makejimmi/FABI/Case Designs/FABI_PCB_Bottom.stl

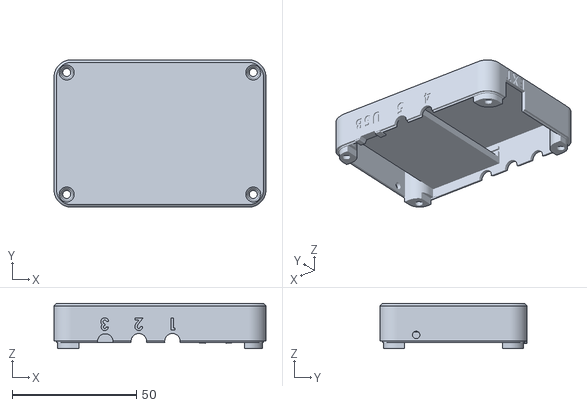
[picture p1: CAD file, 2025-01-18]
Case Designs/FABI_PCB_Bottom.stl
85.2 x 59.2 x 18.2
