makejimmi/FABI/Case Designs/FABI_PCB_Top.stl

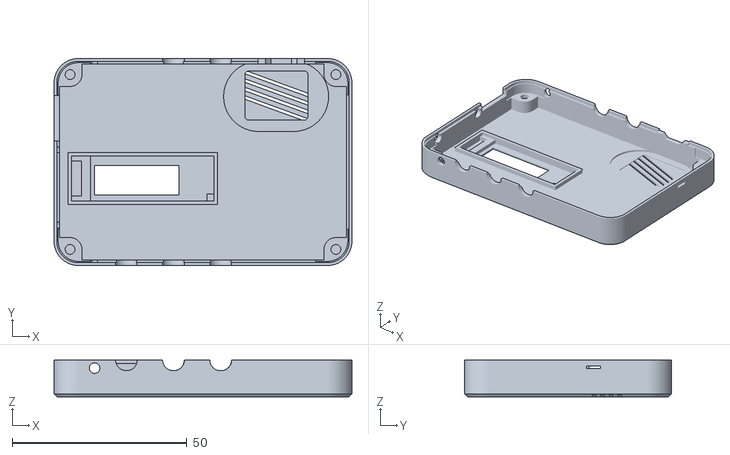
[picture p2: CAD file, 2025-01-18]
Case Designs/FABI_PCB_Top.stl
85.2 x 59.2 x 10.5
