makejimmi/FABI/hardware/FABI_schematic.kicad_pcb

## KiCad design hardware/FABI_schematic.kicad_pcb (2025-01-18)

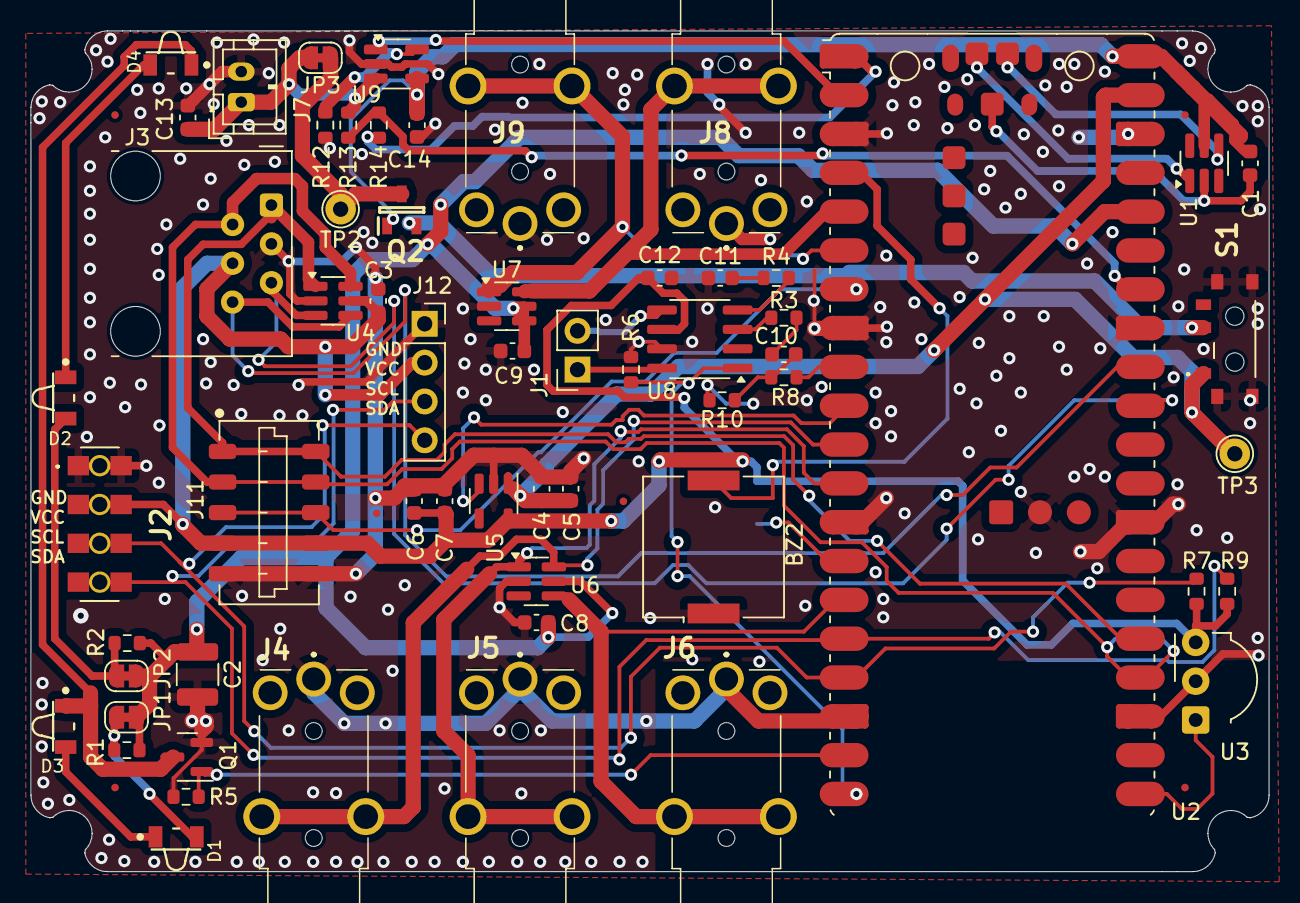
[picture p3: board FABI_schematic.kicad_pcb from above]

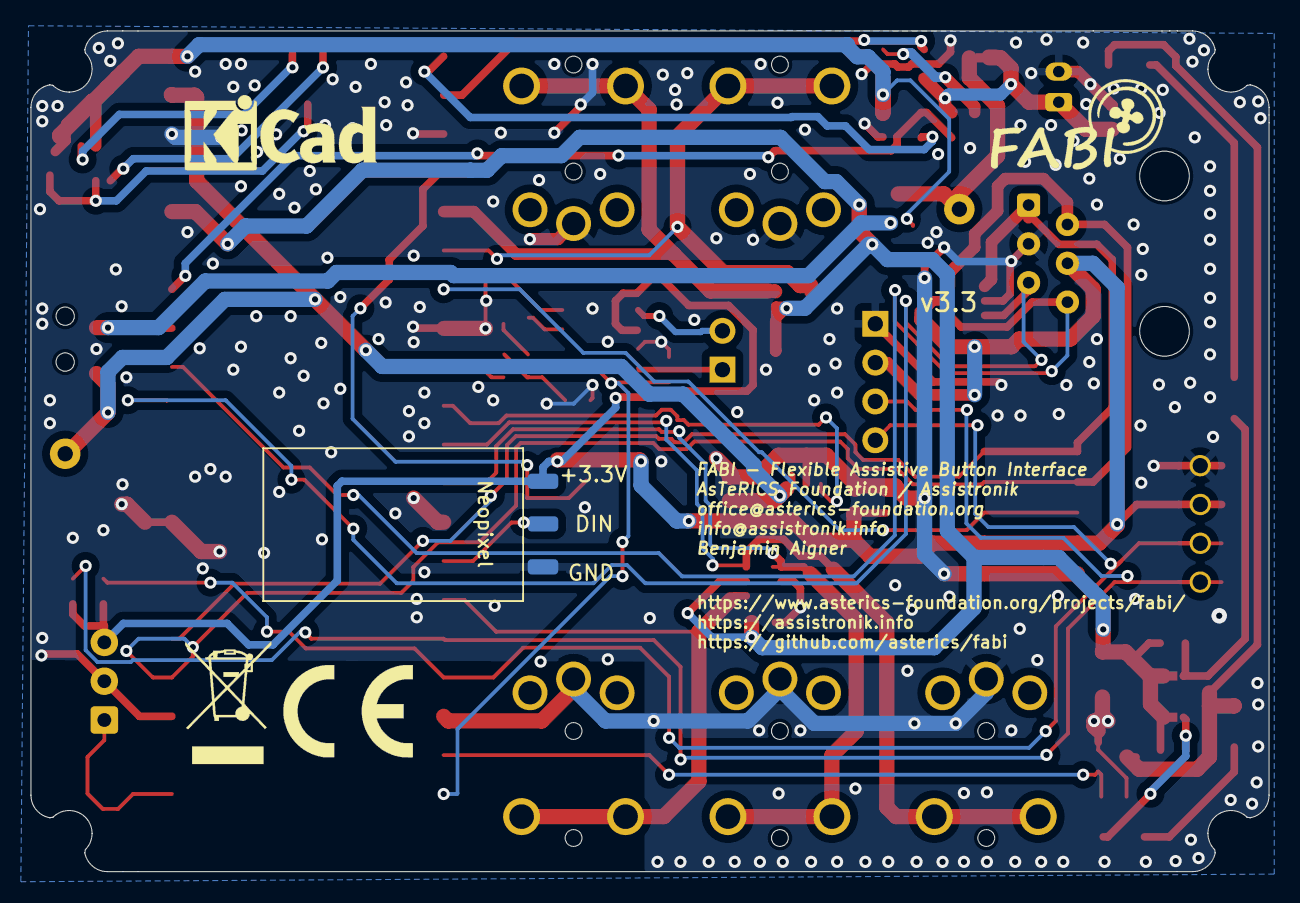
[picture p4: board FABI_schematic.kicad_pcb from below]

Board: 2 copper layers, 81.0 x 55.0 mm, 73 parts (7 on the bottom side), 46 nets.

Parts:
BZ2: PKMCS0909E4000; Buzzer_Murata_PKMCS0909E
C1, C3, C5, C6, C8, C9: 100n; C_0603_1608Metric
C2: 100uF/6.3V; C_1210_3225Metric
C4, C7: 1uF / >6.3V / X7R; C_0603_1608Metric
C10, C11: 1u; C_0603_1608Metric
C12: 10u; C_0603_1608Metric
C13, C14: 4.7u; C_0603_1608Metric
D1, D2, D3, D4: SFH4045; SFH4045N
FID1, FID2, FID3, FID4, FID5, FID6: Fiducial; Fiducial_0.5mm_Mask1mm
J1: Conn_01x02_Pin; PinSocket_1x02_P2.54mm_Vertical
J2: display_connector_91601-304LF; 91601304LF
J3: 54601-906WPLF; RJ12_Amphenol_54601-x06_Horizontal
J4, J5, J6, J8, J9: 54-00174 / FC68125; FC68125
J7: JST PH2P ST; JST_PH_B2B-PH-K_1x02_P2.00mm_Vertical
J11: 009159005551906
J11_GND1, J11_VDD1, J11_data1: Conn_01x01_Male; SolderWirePad_1x01_SMD_1x2mm_NOPASTE
J12: Conn_01x04_Socket; PinSocket_1x04_P2.54mm_Vertical
JP1, JP2, JP3: SolderJumper_2_Bridged; SolderJumper-2_P1.3mm_Bridged_RoundedPad1.0x1.5mm
LOGO1: Logo_FABI; FABI_Logo_s
LOGO2: Logo_KiCAD; KiCad-Logo_5mm_SilkScreen
LOGO3: Logo_CE; CE-Logo_8.5x6mm_SilkScreen
LOGO4: Logo_WEEE; WEEE-Logo_5.6x8mm_SilkScreen
Q1: BSS806; SOT-23
Q2: DMG2305UXQ-7; SOT96P240X110-3N
R1, R2: DNP; R_0603_1608Metric
R3, R4: 100; R_0603_1608Metric
R5, R6, R7, R9: 4k7; R_0603_1608Metric
R8, R10: 10k; R_0603_1608Metric
R12: 3k3; R_0603_1608Metric
R13, R14: 100k; R_0603_1608Metric
S1: 450404015514
TP2, TP3: TestPoint_Probe; TestPoint_THTPad_D2.0mm_Drill1.0mm
U1: D5V0F4U6SO; SC-74-6_1.55x2.9mm_P0.95mm
U2: Pico 2W; RaspberryPi_Pico_W_SMD
U3: TSOP4838; Vishay_MOLD-3Pin
U4, U6, U7: D1213A-04SO-7; SC-74-6_1.55x2.9mm_P0.95mm
U5: MIC5504-3.3YM5; SOT-23-5
U8: PAM8302AAS; SOIC-8_3.9x4.9mm_P1.27mm
U9: MCP73831-2; SOT-23-5_HandSoldering

Connections:
+3.3VADC: C3.1, C6.1, C7.1, C12.2, J2.3, J3.4, J11.4, J11_VDD1.1, J12.2, R7.2, R9.2, U3.3 (Vs), U4.5 (VBUS), U5.5 (VOUT), U8.6 (VDD)
/3V3_ADC_ENABLE: U2.10 (GPIO7), U5.3 (EN)
/Audio_SD: R6.2, U2.20 (GPIO15), U8.1 (~SD)
/Audio_Signal: R8.1, U2.9 (GPIO6)
/BUTTON1: J4.3T, U2.11 (GPIO8), U6.6 (I/O4)
/BUTTON2: J5.3T, U2.12 (GPIO9), U6.1 (I/O1)
/BUTTON3: J6.3T, U2.15 (GPIO11), U6.4 (I/O3)
/BUTTON4: J8.3T, U2.5 (GPIO3), U7.6 (I/O4)
/BUTTON5: J9.3T, U2.6 (GPIO4), U7.1 (I/O1)
/BUZZER: BZ2.2 (+), U2.4 (GPIO2)
/CHARGE_STAT: U2.2 (GPIO1), U9.1 (STAT)
/EXT1: J3.5, U2.31 (GPIO26_ADC0), U4.3 (I/O2)
/EXT2: J3.6, U2.32 (GPIO27_ADC1), U4.4 (I/O3)
/IR_LED: Q1.1 (G), R5.2, U2.19 (GPIO14)
/IR_TSOP: U2.21 (GPIO16), U3.1 (OUT)
/MPRLS_DRDY_RES: J11.3, U2.7 (GPIO5)
/NEOPIXEL: J11_data1.1, U2.14 (GPIO10)
/SCL: J3.1, J11.1, U2.25 (GPIO19), U4.1 (I/O1)
/SCL_INT: J2.5, J12.4, R7.1, U2.17 (GPIO13)
/SDA: J3.2, J11.2, U2.24 (GPIO18), U4.6 (I/O4)
/SDA_INT: J2.7, J12.3, R9.1, U2.16 (GPIO12)
/V_BATT_MEASURE: R13.2, R14.1, U2.34 (GPIO28_ADC2)
/V_BATT_VD_SWITCH: R14.2, U2.1 (GPIO0)
GND: BZ2.1 (-), C2.2, C3.2, C4.2, C5.2, C6.2, C7.2, C8.2, C9.2, C11.1, C12.1, C13.2, C14.2, J2.1, J3.3, J4.1S, J5.1S, J6.1S, J7.2, J8.1S, J9.1S, J11.5, J11_GND1.1, J12.1, Q1.2 (S), R5.1, R6.1, R10.2, R12.2, S1.MP1, S1.MP2, S1.MP3, S1.MP4, U2.3 (GND), U2.8 (GND), U2.13 (GND), U2.18 (GND), U2.23 (GND), U2.28 (GND), U2.33 (AGND), U2.38 (GND), U2.D2 (GND), U3.2 (GND), U4.2 (GND), U5.2 (GND), U6.2 (GND), U7.2 (GND), U8.7 (GND), U9.2 (V_{SS})
unnamed: C10.1, R8.2, R10.1
unnamed: C10.2, R3.2
unnamed: C11.2, R4.2
unnamed: D1.2 (A), JP1.2 (B), R1.1
unnamed: D1.1 (K), D3.2 (A)
unnamed: D2.2 (A), JP2.2 (B), R2.1
unnamed: D2.1 (K), D4.2 (A)
unnamed: D3.1 (K), D4.1 (K), Q1.3 (D)
unnamed: J1.1, U8.8 (OUT-)
unnamed: J1.2, U8.5 (OUT+)
unnamed: JP3.1 (A), Q2.3 (D), TP2.1
unnamed: C1.2, U1.2 (GND), U2.TP1 (USB_GND)
unnamed: U1.1 (I/O1), U2.TP3 (USB_DP)
unnamed: U1.4 (I/O3), U2.TP2 (USB_DM)
unnamed: R3.1, U8.3 (IN+)
unnamed: R4.1, U8.4 (IN-)
unnamed: R12.1, U9.5 (PROG)
VBUS: C1.1, C14.1, Q2.1 (G), U1.5 (VBUS), U2.40 (VBUS), U9.4 (V_{DD})
VCC: C2.1, C8.1, C9.1, JP1.1 (A), JP2.1 (A), R1.2, R2.2, U2.36 (3V3), U6.5 (VBUS), U7.4 (I/O3), U7.5 (VBUS)
VSYS: C4.1, C5.1, S1.1, TP3.1, U2.39 (VSYS), U5.1 (VIN)
V_BATT: C13.1, J7.1, JP3.2 (B), R13.1, U9.3 (V_{BAT})
V_PWR_SWITCH: Q2.2 (S), S1.2
