makejimmi/FABI/FabiWare/modes.cpp

/*
     FLipWare - AsTeRICS Foundation
     For more info please visit: https://www.asterics-foundation.org

     Module: modes.cpp: implementation of stick operation and special modes

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
*/

#include "FlipWare.h"
#include "modes.h"
#include "gpio.h"
#include "tone.h"
#include "utils.h"

/**
   static variables for mode handling
 * */
uint8_t strongSipPuffState = STRONG_MODE_IDLE;
uint8_t mouseMoveCount = 0;
unsigned long currentTime;
unsigned long previousTime = 0;


/**
   forward declarations of module-internal functions
*/
void handleMovement(); 

void handleUserInteraction()
{
  static uint8_t pressureRising = 0, pressureFalling = 0;
  static int previousPressure = 512;
  static int waitStable = 0;
  static int checkPairing = 0;
  static uint8_t puffState = SIP_PUFF_STATE_IDLE, sipState = SIP_PUFF_STATE_IDLE;
  static uint8_t puffCount = 0, sipCount = 0;
  int strongDirThreshold;

  // check physical buttons
  for (int i = 0; i < NUMBER_OF_PHYSICAL_BUTTONS; i++) // update button press / release events
  handleButton(i, digitalRead(input_map[i]) == LOW ? 1 : 0);

  #ifdef FLIPMOUSE
    // check "long-press" of internal button unpairing all BT hosts
    if (digitalRead(input_map[0]) == LOW) {
      checkPairing++;
      if (checkPairing == 800) {   // approx 4 sec.
        makeTone(TONE_BT_PAIRING, 0);
        unpairAllBT();
        checkPairing = 0;
      }
    } else checkPairing = 0;
  #endif  

  // check sip/puff activities
  if (sensorData.pressure > previousPressure) pressureRising = 1; else pressureRising = 0;
  if (sensorData.pressure < previousPressure) pressureFalling = 1; else pressureFalling = 0;
  previousPressure = sensorData.pressure;

  if (slotSettings.stickMode == STICKMODE_ALTERNATIVE)
    strongDirThreshold = 0;
  else strongDirThreshold = STRONGMODE_MOUSE_JOYSTICK_THRESHOLD;

  // handle strong sip and puff actions
  switch (strongSipPuffState)  {

    case STRONG_MODE_IDLE:   // IDLE
      if (sensorData.pressure > slotSettings.sp) {
        strongSipPuffState = STRONG_MODE_ENTER_STRONGPUFF;
        makeTone(TONE_ENTER_STRONGPUFF, 0 );
      }
      if (sensorData.pressure < slotSettings.ss ) {
        strongSipPuffState = STRONG_MODE_ENTER_STRONGSIP;
        makeTone(TONE_ENTER_STRONGSIP, 0 );
      }
      break;

    case STRONG_MODE_ENTER_STRONGPUFF:     // puffed strong, wait for release
      if (sensorData.pressure < slotSettings.tp)
        waitStable++;
      else waitStable = 0;
      if (waitStable >= STRONGMODE_STABLETIME)
        strongSipPuffState = STRONG_MODE_STRONGPUFF_ACTIVE;
      break;

    case STRONG_MODE_STRONGPUFF_ACTIVE:    // strong puff mode active
      if (sensorData.y < -strongDirThreshold) {
        makeTone(TONE_EXIT_STRONGPUFF, 0 );
        handlePress(STRONGPUFF_UP_BUTTON); handleRelease(STRONGPUFF_UP_BUTTON);
        strongSipPuffState = STRONG_MODE_RETURN_TO_IDLE;
        waitStable = 0;
      }
      else if (sensorData.x < -strongDirThreshold) {
        makeTone(TONE_EXIT_STRONGPUFF, 0 );
        handlePress(STRONGPUFF_LEFT_BUTTON); handleRelease(STRONGPUFF_LEFT_BUTTON);
        strongSipPuffState = STRONG_MODE_RETURN_TO_IDLE;
        waitStable = 0;
      }
      else if (sensorData.x > strongDirThreshold) {
        makeTone(TONE_EXIT_STRONGPUFF, 0 );
        handlePress(STRONGPUFF_RIGHT_BUTTON); handleRelease(STRONGPUFF_RIGHT_BUTTON);
        strongSipPuffState = STRONG_MODE_RETURN_TO_IDLE;
        waitStable = 0;
      }
      else if (sensorData.y > strongDirThreshold) {
        makeTone(TONE_EXIT_STRONGPUFF, 0 );
        handlePress(STRONGPUFF_DOWN_BUTTON); handleRelease(STRONGPUFF_DOWN_BUTTON);
        strongSipPuffState = STRONG_MODE_RETURN_TO_IDLE;
        waitStable = 0;
      }
      else {
        waitStable++;
        if (waitStable > STRONGMODE_EXIT_TIME) { // no stick movement occurred: perform strong puff action
          waitStable = 0;
          handlePress(STRONGPUFF_BUTTON);
          handleRelease(STRONGPUFF_BUTTON);
          strongSipPuffState = STRONG_MODE_RETURN_TO_IDLE;
        }
      }
      break;

    case STRONG_MODE_ENTER_STRONGSIP:   // sipped strong, wait for release
      if (sensorData.pressure > slotSettings.ts)
        waitStable++;
      else waitStable = 0;
      if (waitStable >= STRONGMODE_STABLETIME)
        strongSipPuffState = STRONG_MODE_STRONGSIP_ACTIVE;
      break;

    case STRONG_MODE_STRONGSIP_ACTIVE:   // strong sip mode active
      if (sensorData.y < -strongDirThreshold) {
        makeTone(TONE_EXIT_STRONGSIP, 0 );
        handlePress(STRONGSIP_UP_BUTTON); handleRelease(STRONGSIP_UP_BUTTON);
        strongSipPuffState = STRONG_MODE_RETURN_TO_IDLE;
        waitStable = 0;
      }
      else if (sensorData.x < -strongDirThreshold) {
        makeTone(TONE_EXIT_STRONGSIP, 0 );
        handlePress(STRONGSIP_LEFT_BUTTON); handleRelease(STRONGSIP_LEFT_BUTTON);
        strongSipPuffState = STRONG_MODE_RETURN_TO_IDLE;
        waitStable = 0;
      }
      else if (sensorData.x > strongDirThreshold) {
        makeTone(TONE_EXIT_STRONGSIP, 0 );
        handlePress(STRONGSIP_RIGHT_BUTTON); handleRelease(STRONGSIP_RIGHT_BUTTON);
        strongSipPuffState = STRONG_MODE_RETURN_TO_IDLE;
        waitStable = 0;
      }
      else if (sensorData.y > strongDirThreshold) {
        makeTone(TONE_EXIT_STRONGSIP, 0 );
        handlePress(STRONGSIP_DOWN_BUTTON); handleRelease(STRONGSIP_DOWN_BUTTON);
        strongSipPuffState = STRONG_MODE_RETURN_TO_IDLE;
        waitStable = 0;
      }
      else {
        waitStable++;
        if (waitStable > STRONGMODE_EXIT_TIME) {  // no stick movement occurred: perform strong sip action
          waitStable = 0;
          handlePress(STRONGSIP_BUTTON);
          handleRelease(STRONGSIP_BUTTON);
          strongSipPuffState = STRONG_MODE_RETURN_TO_IDLE;
        }
      }
      break;

    case STRONG_MODE_RETURN_TO_IDLE:
      waitStable++;
      if (waitStable > STRONGMODE_IDLE_TIME)
      {
        waitStable = 0;
        strongSipPuffState = STRONG_MODE_IDLE;
        initDebouncers();
        puffState = 0; sipState = 0;
      }
      break;
    default: break;
  }


  if (strongSipPuffState == STRONG_MODE_IDLE)
  {

    //handle normal sip and puff actions
    switch (puffState)  {
      case SIP_PUFF_STATE_IDLE:
        if (sensorData.pressure > slotSettings.tp)   // handle single puff actions
        {
          makeTone(TONE_INDICATE_PUFF, 0);
          puffState = SIP_PUFF_STATE_STARTED; puffCount = 0;
        }
        break;

      case SIP_PUFF_STATE_STARTED:
        if (!pressureRising)
        {
          if (puffCount++ > SIP_PUFF_SETTLE_TIME)
          {
            puffCount = MIN_HOLD_TIME;
            handlePress(PUFF_BUTTON);
            puffState = SIP_PUFF_STATE_PRESSED;
          }
        } else if (puffCount) puffCount--;
        break;

      case SIP_PUFF_STATE_PRESSED:
        if (puffCount) puffCount--;
        if ((sensorData.pressure < slotSettings.tp) && (!puffCount)) {
          handleRelease(PUFF_BUTTON);
          puffState = 0;
        }
    }

    switch (sipState)  {
      case SIP_PUFF_STATE_IDLE:
        if (sensorData.pressure < slotSettings.ts)   // handle single sip actions
        {
          makeTone(TONE_INDICATE_SIP, 0);
          sipState = SIP_PUFF_STATE_STARTED; sipCount = 0;
        }
        break;

      case SIP_PUFF_STATE_STARTED:
        if (!pressureFalling)
        {
          if (sipCount++ > SIP_PUFF_SETTLE_TIME)
          {
            sipCount = MIN_HOLD_TIME;
            handlePress(SIP_BUTTON);
            sipState = SIP_PUFF_STATE_PRESSED;
          }
        } else if (sipCount) sipCount--;
        break;

      case SIP_PUFF_STATE_PRESSED:
        if (sipCount) sipCount--;
        if ((sensorData.pressure > slotSettings.ts) && (!sipCount)) {
          handleRelease(SIP_BUTTON);
          sipState = 0;
        }
    }

    // now handle stick movements!
    handleMovement();
  }
}

/**
   @name getAccelFactor
   @brief calculates acceleration for mouse pointer movements 
          according to sensordata and acceleration settings 
   @return float value of current acceleration factor
*/
float getAccelFactor() {
  static float accelFactor=0;
  static int xo = 0, yo = 0;
  static float accelMaxForce = 0, lastAngle = 0;

  if (sensorData.force == 0) {
    accelFactor = 0;
    accelMaxForce = 0;
    lastAngle = 0;
  }
  else {
    if (sensorData.force > accelMaxForce) accelMaxForce = sensorData.force;
    if (sensorData.force > accelMaxForce * 0.8f) {
      if (accelFactor < 1.0f)
        accelFactor += ((float)slotSettings.ac / 5000000.0f);
    }
    else if (accelMaxForce > 0) accelMaxForce *= 0.99f;

    if (sensorData.force < accelMaxForce * 0.6f)  accelFactor *= 0.995f;
    if (sensorData.force < accelMaxForce * 0.4f)  accelFactor *= 0.99f;

    float dampingFactor = fabsf(sensorData.x - xo) + fabsf(sensorData.y - yo);
    accelFactor *= (1.0f - dampingFactor / 1000.0f);
    lastAngle = sensorData.angle;
    xo = sensorData.x; yo = sensorData.y;
  }
  (void)lastAngle; //avoid compiler warnings on unused variable. TODO: necessary value?
  return(accelFactor);
}

/**
   @name acceleratedMouseMove
   @brief performs accelerated mouse pointer movement
   @param accelFactor current acceleration factor
   @return none
*/
void acceleratedMouseMove(float accelFactor) {
  static float accumXpos = 0;
  static float accumYpos = 0;

  float moveValX = sensorData.x * (float)slotSettings.ax * accelFactor;
  float moveValY = sensorData.y * (float)slotSettings.ay * accelFactor;
  float actSpeed =  __ieee754_sqrtf (moveValX * moveValX + moveValY * moveValY);
  float max_speed = (float)slotSettings.ms / 3.0f;

  if (actSpeed > max_speed) {
    moveValX *= (max_speed / actSpeed);
    moveValY *= (max_speed / actSpeed);
    accelFactor *= 0.98f;
  }

  accumXpos += moveValX;
  accumYpos += moveValY;

  int xMove = (int)accumXpos;
  int yMove = (int)accumYpos;
  
  if ((xMove != 0) || (yMove != 0)) {
    mouseMove(xMove, yMove);
  }

  accumXpos -= xMove;
  accumYpos -= yMove;
}

/**
   @name scaleJoystickAxis
   @brief scales/crops coordinate values to joystick coordinates (0-1023, centered around 512)
   @param val x/y coordinate value to be scaled
   @return integer value for joystick coordinate
*/
int scaleJoystickAxis (float val) {
  int axis = 512 + (int) (val / 50);
  if (axis < 0) axis = 0; 
  else if (axis > 1023) axis = 1023;
  return (axis);
}

/**
   @name handleMovement
   @brief performs an action or movement according to the current sensorData and mode of operation
   @return none
*/
void handleMovement() 
{
  //static int upState=0,downState=0,leftState=0,rightState=0;
  
  if ((sensorData.autoMoveX != 0) || (sensorData.autoMoveY != 0)) // handle movement induced by button actions
  {
    if (mouseMoveCount++ % 4 == 0)
      mouseMove(sensorData.autoMoveX, sensorData.autoMoveY);
  }

  switch (slotSettings.stickMode) {  

    case STICKMODE_MOUSE:   // handle mouse stick mode
      acceleratedMouseMove(getAccelFactor());
      break; 
     
    case STICKMODE_ALTERNATIVE:  // handle alternative actions stick mode
      handleButton(UP_BUTTON,  sensorData.y < 0 ? 1 : 0);
      handleButton(DOWN_BUTTON,  sensorData.y > 0 ? 1 : 0);
      handleButton(LEFT_BUTTON,  sensorData.x < 0 ? 1 : 0);
      handleButton(RIGHT_BUTTON,  sensorData.x > 0 ? 1 : 0);
      break;
      
    case STICKMODE_JOYSTICK_XY:
      joystickAxis(scaleJoystickAxis((float)sensorData.x * slotSettings.ax), \
        scaleJoystickAxis((float)sensorData.y * slotSettings.ay),0);
      break;

    case STICKMODE_JOYSTICK_ZR:
      joystickAxis(scaleJoystickAxis((float)sensorData.x * slotSettings.ax), \
        scaleJoystickAxis((float)sensorData.y * slotSettings.ay),1);
      break;

    case STICKMODE_JOYSTICK_SLIDERS:
      joystickAxis(scaleJoystickAxis((float)sensorData.x * slotSettings.ax), \
        scaleJoystickAxis((float)sensorData.y * slotSettings.ay),2);
      break;
  }
}
