makejimmi/FABI/FabiWare/buttons.h

/*
      FLipWare - AsTeRICS Foundation
     For more info please visit: https://www.asterics-foundation.org

     Module: buttons.h - header file for the button handling

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
*/


#ifndef _BUTTONS_H_
#define _BUTTONS_H_

// Constants and Macro definitions
#define DEFAULT_DEBOUNCING_TIME 5   // debouncing interval for button-press / release

/**
   definition of Button numbers/indices of the "virtual buttons"
   (these are not pin numbers but button function identifiers!)
*/

#ifdef FABI
  #define NUMBER_OF_BUTTONS  20         // number of physical + virtual switches. Note: if higher than 32, change buttonStates to uint64_t!
  // (buttons 0-4 are the physical switches on the device)  
  #define SIP_BUTTON              5
  #define STRONGSIP_BUTTON        6
  #define PUFF_BUTTON             7
  #define STRONGPUFF_BUTTON       8

  #define UP_BUTTON               9
  #define DOWN_BUTTON             10
  #define LEFT_BUTTON             11
  #define RIGHT_BUTTON            12

  #define STRONGSIP_UP_BUTTON     13
  #define STRONGSIP_DOWN_BUTTON   14
  #define STRONGSIP_LEFT_BUTTON   15
  #define STRONGSIP_RIGHT_BUTTON  16
  
  #define STRONGPUFF_UP_BUTTON    17
  #define STRONGPUFF_DOWN_BUTTON  18
  #define STRONGPUFF_LEFT_BUTTON  19
  #define STRONGPUFF_RIGHT_BUTTON 20
#endif  

#ifdef FLIPMOUSE
  #define NUMBER_OF_BUTTONS  19         // number of physical + virtual switches. Note: if higher than 32, change buttonStates to uint64_t!
  // (buttons 0-2 are the physical switches on the device)
  #define UP_BUTTON                3
  #define DOWN_BUTTON              4
  #define LEFT_BUTTON              5
  #define RIGHT_BUTTON             6
  
  #define SIP_BUTTON               7
  #define STRONGSIP_BUTTON         8
  #define PUFF_BUTTON              9
  #define STRONGPUFF_BUTTON       10
  
  #define STRONGSIP_UP_BUTTON     11
  #define STRONGSIP_DOWN_BUTTON   12
  #define STRONGSIP_LEFT_BUTTON   13
  #define STRONGSIP_RIGHT_BUTTON  14
  
  #define STRONGPUFF_UP_BUTTON    15
  #define STRONGPUFF_DOWN_BUTTON  16
  #define STRONGPUFF_LEFT_BUTTON  17
  #define STRONGPUFF_RIGHT_BUTTON 18
#endif

 

/**
   slotButtonSettings struct
   contains button mode identfier and value
   multiple of these constitute the button settings for the active slot
*/
struct slotButtonSettings {
  uint16_t mode;
  int16_t value;
};

/**
   buttonDebouncerType struct
   contains state and timing values for button press / release actions
   needed for debouncing, anti-tremor calculations and longpress detection
*/
struct buttonDebouncerType {
  uint8_t bounceCount;
  uint8_t bounceState;
  uint8_t stableState;
  uint8_t longPressed;
  uint32_t timestamp;
} ;

/**
   extern declarations of data structures 
   which can be accessed from different modules
*/
extern struct slotButtonSettings buttons[NUMBER_OF_BUTTONS];
extern char* buttonKeystrings[NUMBER_OF_BUTTONS];
extern uint32_t buttonStates;


/**
   @name initButtons
   @brief initialize button data structure and default values
   @return none
*/
void initButtons();


/**
   @name initButtonKeystrings
   @brief initialize/clear keystrings parameters of current slot
   @return none
*/
void initButtonKeystrings();

/**
   @name getButtonKeystring
   @brief get n-th keystring parameter of current slot
   @return char pointer to the keystring
*/
char * getButtonKeystring(int num);


/**
   @name getButtonKeystring
   @brief set n-th keystring parameter of current slot
   @param buttonIndex: number of button (index of keystring in keystring buffer)
   @param text: pointer to string which shall be copied to keystring buffer
   @return number of free bytes remaining in keystring buffer
*/
uint16_t setButtonKeystring(uint8_t buttonIndex, char const * text);

/**
   @name handlePress
   @brief handles a press detection of button n
   @param buttonIndex: number of button which was pressed
   @return none
*/
void handlePress (int buttonIndex);      // a button was pressed


/**
   @name handleRelease
   @brief handles a release detection of button n
   @param buttonIndex: number of button which was released
   @return none
*/
void handleRelease (int buttonIndex);    // a button was released

/**
   @name handleButton
   @brief process press and release actions for a particular button
   @param i: number of button to be processed
   @param state: current state (1:pressed, 0:released) raw value (without debouncing)
   @return none
*/
uint8_t handleButton(int i, uint8_t state);    // button debouncing and longpress detection


/**
   @name inHoldMode
   @brief returns if a button is currently in a state where an action remains held during press
   @param i: number of button to be checked
   @return true or false
*/
uint8_t inHoldMode (int i);

/**
   @name initDebounces
   @brief initialises / clears the debounciong data structures for all buttons
   @return none
*/
void initDebouncers();

#endif
