makejimmi/FABI/FabiWare/display.cpp

/*
     FabiWare - AsTeRICS Foundation
     For more info please visit: https://www.asterics-foundation.org

     Module: display.cpp - implementation of the Oled display functions 

     Note: Oled display connects to I2C-1 (Wire) for FlipMouse
     The utilized library is https://github.com/greiman/SSD1306Ascii

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
*/

#include <Arduino.h>
#include "FlipWare.h"
#include "gpio.h"
#include "SSD1306Ascii.h"
#include "SSD1306AsciiWire.h"
#include "display.h"

#define SCREEN_ADDRESS 0x3C

uint8_t displayInstalled=0;
SSD1306AsciiWire *oled;    // pointer to the display driver class


/**
   @name displayInit
   @param uint8_t useWire1:  true if Wire1 should be used, else use Wire
   @return uint_t: returns true if display was found, else false

   initialises the i2c-communication and display module, prints out module name
*/
uint8_t displayInit (uint8_t useWire1) {
  if (useWire1) {
  #ifdef FABI
    Wire1.setSDA(PIN_WIRE1_SDA_);
    Wire1.setSCL(PIN_WIRE1_SCL_);
    Wire1.begin();
  #endif
    Wire1.beginTransmission(SCREEN_ADDRESS);  
    if (Wire1.endTransmission()) return (false);
    oled = new SSD1306AsciiWire(Wire1);
  } else {
  #ifdef FABI
    Wire.setSDA(PIN_WIRE0_SDA_);
    Wire.setSCL(PIN_WIRE0_SCL_);
    Wire.begin();
  #endif
    Wire.beginTransmission(SCREEN_ADDRESS);  
    if (Wire.endTransmission()) return (false);
    oled = new SSD1306AsciiWire(Wire);
  }
  
  oled->begin(&Adafruit128x32, SCREEN_ADDRESS);
  oled->setFont(Adafruit5x7);
  //oled->setFont(Arial_bold_14);
  //displayClear();
  //oled->set2X();
  //oled->print(moduleName);
  displayInstalled = 1;
  return true;
}


/**
   @name displayClear
   @param none
   @return none

   clears the display and sets correct rotation and display mode
*/
void displayClear(void) {
  oled->clear();
  if (slotSettings.ro>90)
    oled->displayRemap(true);
  else oled->displayRemap(false);
  oled->setInvertMode(false);
}


/**
   @name displayMessage
   @param char * msg: string which is printed
   @return none

   clears the display and prints message (center line, double sized)
*/
void displayMessage(char * msg) {
  if (!displayInstalled) return;
  displayClear();
  oled->set2X();
  oled->setCursor(5,1);
  oled->print(msg);  
}

/**
   @name displayUpdate
   @param none
   @return none

   clear display, then print current slotname and mode information
*/
void displayUpdate(void) {
  if (!displayInstalled) return;
  displayClear();
  oled->set2X();
  oled->setCursor(5,1);
  oled->print(slotSettings.slotName);  

  oled->set1X();

  // display modes for FLipPad
  #ifndef FABI
  oled->setCursor(100,0);
  switch (slotSettings.stickMode) {
    case 0:
    case 1: oled->print("Stk"); break;
    case 2:
    case 3:
    case 4: oled->print("Joy"); break;
  }
  #endif  

  oled->setCursor(100,3);
  switch (slotSettings.bt) {
    case 1: oled->print("USB"); break;
    case 2: oled->print("BT"); break;
    case 3: oled->print("both"); break;
  }

  // Display the battery percentage on the display
  // The battery percentage shall be read in a regular interval
  oled->setCursor(96, 1);
  int8_t battValue = sensorData.currentBattPercent;
  switch(battValue){
    case -1: // USB power - no battery
      oled->print("none"); break;
    case 127:
      oled->print("ch"); break;
    case 101:
      oled->print("full"); break;
    default:
      char* buffer = (char*)calloc(6, sizeof(char));
      sprintf(buffer, "%d%%", battValue);
      oled->print(buffer); free(buffer); break;
  }
}
