makejimmi/FABI/FabiWare/reporting.cpp

/*
     FabiWare - AsTeRICS Foundation
     For more info please visit: https://www.asterics-foundation.org

     Module: reporting.h - implementation of serial reports

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
*/  


#include "FlipWare.h"
#include "parser.h"
#include "reporting.h"

/**
  static variables for report management
*/
uint8_t reportRawValues = 0;

/**
   @name makehex
   @param uint32_t val
   @param char* str - the target string
   @return none
   translates an uint32 integer value into a hex value
   the hex value is stored into a zero-terminated string (str)
   (with leading zeros, starting with "0x", eg. "0x00ACAB")
*/
void makehex(uint32_t val, char* str) {
  str[0] = '0';
  str[1] = 'x';
  for (int i = 7; i >= 2; i--) {
    int digit = val % 16;
    if (digit > 9) str[i] = 'a' + digit - 10;
    else str[i] = '0' + digit;
    val >>= 4;
  }
  str[8] = 0;
}


/** 
 * @brief Print current to given stream
 * @param S Stream to send the AT commands to; in our case Serial or a File
 */
void printCurrentSlot(Stream *S)
{
  char tmp[10];
  S->println(slotSettings.slotName);
  #ifdef FLIPMOUSE
    S->print("AT AX "); S->println(slotSettings.ax);
    S->print("AT AY "); S->println(slotSettings.ay);
    S->print("AT DX "); S->println(slotSettings.dx);
    S->print("AT DY "); S->println(slotSettings.dy);
    S->print("AT MS "); S->println(slotSettings.ms);
    S->print("AT AC "); S->println(slotSettings.ac);
    S->print("AT MM "); S->println(slotSettings.stickMode);
    S->print("AT GV "); S->println(slotSettings.gv);
    S->print("AT RV "); S->println(slotSettings.rv);
    S->print("AT GH "); S->println(slotSettings.gh);
    S->print("AT RH "); S->println(slotSettings.rh);
    S->print("AT RO "); S->println(slotSettings.ro);
    S->print("AT SB "); S->println(slotSettings.sb);
  #endif  
  //IR timeout only if not default value
  if(get_IR_timeout() != IR_EDGE_TIMEOUT_US) {
    S->print("AT IT "); S->println(get_IR_timeout());
  }
  S->print("AT TS "); S->println(slotSettings.ts);
  S->print("AT TP "); S->println(slotSettings.tp);
  S->print("AT WS "); S->println(slotSettings.ws);
  S->print("AT SP "); S->println(slotSettings.sp);
  S->print("AT SS "); S->println(slotSettings.ss);
  S->print("AT BT "); S->println(slotSettings.bt);
  S->print("AT KL "); S->println(slotSettings.kbdLayout);
  S->print("AT SC "); makehex(slotSettings.sc, tmp); S->println(tmp);

  for (int i = 0; i < NUMBER_OF_BUTTONS; i++)
  {
    S->print("AT BM ");
    if (i < 9) S->print("0"); // leading zero for button numbers !
    S->println(i + 1);
    int actCmd = buttons[i].mode;
    char cmdStr[4];

    if ((actCmd <0 ) || (actCmd>=NUM_COMMANDS)) {
      S->print("E: buttonmode =");
      S->println(actCmd);
      actCmd=CMD_NC;
    }
    
    S->print("AT ");
    strcpy_FM(cmdStr, (uint_farptr_t_FM)atCommands[actCmd].atCmd);
    S->print(cmdStr);
    switch (pgm_read_byte_near(&(atCommands[actCmd].partype)))
    {
      case PARTYPE_UINT:
      case PARTYPE_INT:  S->print(" "); S->print(buttons[i].value); break;
      case PARTYPE_STRING: S->print(" "); S->print(buttonKeystrings[i]); break;
    }
    S->println("");
  }
  S->flush();
}

void reportValues()
{
  static uint8_t valueReportCount = 0;
  
  if (!reportRawValues)   return;

  if (valueReportCount++ > 50/UPDATE_INTERVAL) {      // report raw values approx. every 50ms !
    int32_t u=sensorData.yRaw+512; int32_t d=512-sensorData.yRaw;   // just for GUI compatibility with V2 (bar displays up/down)
    int32_t l=sensorData.xRaw+512; int32_t r=512-sensorData.xRaw;   // just for GUI compatibility with V2 (bar displays left/right)
    Serial.print("VALUES:"); Serial.print(sensorData.pressure); Serial.print(",");
    #ifdef FLIPMOUSE
    Serial.print(u); Serial.print(","); Serial.print(d); Serial.print(",");
    Serial.print(l); Serial.print(","); Serial.print(r); Serial.print(",");
    Serial.print(sensorData.xRaw); Serial.print(","); Serial.print(sensorData.yRaw); Serial.print(",");
    #endif
    for (uint8_t i = 0; i < NUMBER_OF_BUTTONS; i++)
    {
      if (buttonStates & (1 << i)) Serial.print("1");
      else Serial.print("0");
    }
    Serial.print(",");
    Serial.print(actSlot);
    Serial.println("");
    //  TBD:remove?
    #ifdef FLIPMOUSE
    Serial.print(",");
    Serial.print(sensorData.xDriftComp);
    Serial.print(",");
    Serial.print(sensorData.yDriftComp);
    Serial.println("");
    #endif    
    valueReportCount = 0;
  }
}
