makejimmi/FABI/FabiWare/display.h

/*
     FabiWare - AsTeRICS Foundation
     For more info please visit: https://www.asterics-foundation.org

     Module: display.h - implementation of the Oled display functions 

     Note: Oled display connects to I2C-1 (Wire) for FlipMouse
     The utilized library is https://github.com/greiman/SSD1306Ascii

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
*/

#ifndef _DISPLAY_H_
#define _DISPLAY_H_

/**
   extern declaration of static variables
   which shall be accessed from other modules
*/
extern uint8_t displayInstalled;

/**
   @name displayInit
   @brief initalizes the SSD1306 LCD using I2C interface
   @param useWire1 true if I2C interface 1 (the second I2C) shall be used
   @return true if LCD could be initialized, false if not
*/
uint8_t displayInit (uint8_t useWire1);

/**
   @name displayClear
   @brief clears content of SSD1306 LCD
   @return none
*/
void displayClear(void);

/**
   @name displayUpdate
   @brief clears content of SSD1306 LCD according to slot settings
   @return none
*/
void displayUpdate(void);

/**
   @name displayUpdate
   @brief displays a message on the SSD1306 LCD 
   @param msg message string 
   @return none
*/
void displayMessage(char * msg);
#endif
