makejimmi/FABI/(commit log)

2024-11-18 Moved U4 Component needed for External Sensor in order to gain more space
    [FABI_schematic.kicad_pcb]
2024-11-18 Added all prev. modifications to SRC_v3.0 update by ChrisVeigl; Removed redundant LDO; Most components of the BMS is on the board except for testpoints and battery measurement resistors; Wired most c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
    [FABI_schematic.kicad_pcb, FABI_schematic.kicad_sch]
2024-11-18 Ran DRC and fixued some warnings
    [FABI_schematic.kicad_pcb]
2024-11-19 Moved S-Diode over to PWR_Switch (far right); Rewired all the added components; Moved R7 & R9 so TP3 + PWR_Switch + S-Diode would have space; Made space for TP2 & TP4 and wired them accordingly; Ran 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
    [FABI_schematic.kicad_pcb]
2024-11-20 Ran DRC again and fixed the issues of yesterday's (19.11.24) commit, the issues lied in two ground islands on the B.Cu that were not connected; Rereouted BUTTON4 route in the area of J8 and the NET-(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
    [FABI_schematic.kicad_pcb]
2024-11-22 Added missing sheet which caused problems for collaborators when trying to open the schematic
    [lpw1.kicad_sch]
2024-11-29 Added solder jumper between BAT and p-MOS; Rewired battery level measurem. to GPIO pin in order to have it off when not needed; Changed all Rs into EU Rs; Renamed all components for them to be unifor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
    [FABI_schematic.kicad_pcb, FABI_schematic.kicad_sch, lpw1.kicad_sch]
2024-11-30 Done more finetuning; No more ADC Pin on the Pico W left, waiting for response/recommendation of prof.; Made sure that every route is correct; Added new GPIO inputs, namely voltage divider so it woul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
    [FABI_schematic.kicad_pcb, FABI_schematic.kicad_sch, lpw1.kicad_sch]
2024-11-30 Checked for correct wiring of new conductor tracks (new, in the scope of this project); Layout improved;
    [FABI_schematic.kicad_pcb, lpw1.kicad_sch]
2024-12-02 Changed pins for J3 connector as it's sufficient to have I2C1 (GP18, GP19) for SDA/SCL, does not need ADC; V_BATT_MEASURE now uses GP28 with the built-in ADC; Connector J12 now uses 3.3V as well (fro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
    [FABI_schematic.kicad_pcb, FABI_schematic.kicad_sch, lpw1.kicad_sch]
2024-12-04 Removed PWR_FLAGS except for VSYS; Removed NT2 (obsolete); Updated Schematics PDF; Reduced V_PWR_SWITCH routes to 1 from 2 to make space for VCC due to it being routed around the mounting holes of co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
    [FABI_schematic.kicad_pcb, FABI_schematic.kicad_sch, lpw1.kicad_sch]
2024-12-04 Moved FABI Logo; Changed some names; Changed VSYS label on LPW1; Updated SCH PDF;
    [FABI_schematic.kicad_pcb, lpw1.kicad_sch]
2025-01-03 Changed some labels and added minor details
    [FABI_schematic.kicad_pcb]
2025-01-03 Added sheet comments
    [lpw1.kicad_sch]
2025-01-15 removed short between Mosfet G/S, some other minor changes
    [FABI_schematic.kicad_pcb, lpw1.kicad_sch]
2025-01-17 Added battery management functions & inactivity management & power sleep (lpwFuncs); New pins defined (lpwFuncs); Added new variables to sensorData struct (FlipWare.h); Added battery display (display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
    [FabiWare.ino, FlipWare.h, buttons.cpp, display.cpp, display.h, lpwFuncs.cpp, lpwFuncs.h, powman.c]
2025-01-17 Added battery management, inactivity management and new pin definitions (lpwFuncs); Added new variables to SensorData struct (FlipWare.h); Modified displayUpdate() to constitute battery (display.cpp)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
    [FabiWare.ino, FlipWare.h, display.cpp, lpwFuncs.cpp, powman.c, powman.h, rosc.c, rosc.h]
2025-01-18 Added Battery Bed + Hole for Power Switch
    [FABI_PCB_Bottom.stl, FABI_PCB_Top.stl]
2025-01-18 Adjusted routing to improve ground/copper area coverage; Added 3D models
    [FABI_schematic.kicad_pcb]
2025-01-20 Moved all 3rd party files into a separate folder powermanagement; Improved reliability of battery read;
2025-05-21 Changed dormant interrupt source from one wake up pin to all pins specified by input_map[]
    Added pull ups to dormant interrupt pins to tackle occasional and unwanted wake ups
2025-05-21 Added function 'initDormant'; gets dormant mode power consumption down to ~4.5mA; sometimes drops down to ~700uA, why?
    -> refer to Setup in new temporary branch 'fm-fabi' in Fork
2025-05-22 Added 'goingDormant' flag to address conflict with periodic I2C device checks; current in DORMANT: ~700 uA now
    potential reason: interrupted i2c transaction during sleep transition? the likelihood is very low for that to happen
